dogukan-bicer/Marel-Arge/README.md

# Marel-Arge
marel arge çalışma dosyaları
