dogukan-bicer/Marel-Arge/Pcb Dosyaları/Robotik Sistem/versiyon1.2 dogukan/v1.1.png

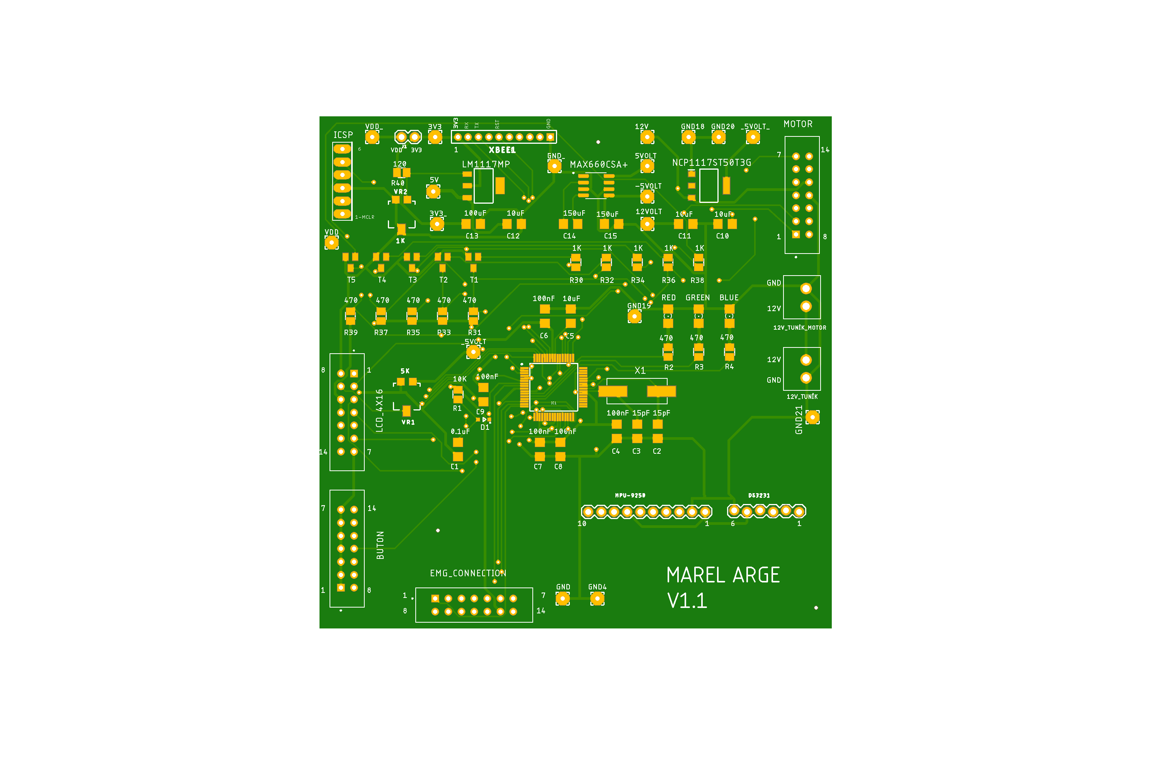
Pcb Dosyaları/Robotik Sistem/versiyon1.2 dogukan/v1.1.png
