dogukan-bicer/Marel-Arge/Pcb Dosyaları/Eldiven/eldiven/Mareltek Glove Project_esp32.brd

## EAGLE design Pcb Dosyaları/Eldiven/eldiven/Mareltek Glove Project_esp32.brd (2024-05-18)

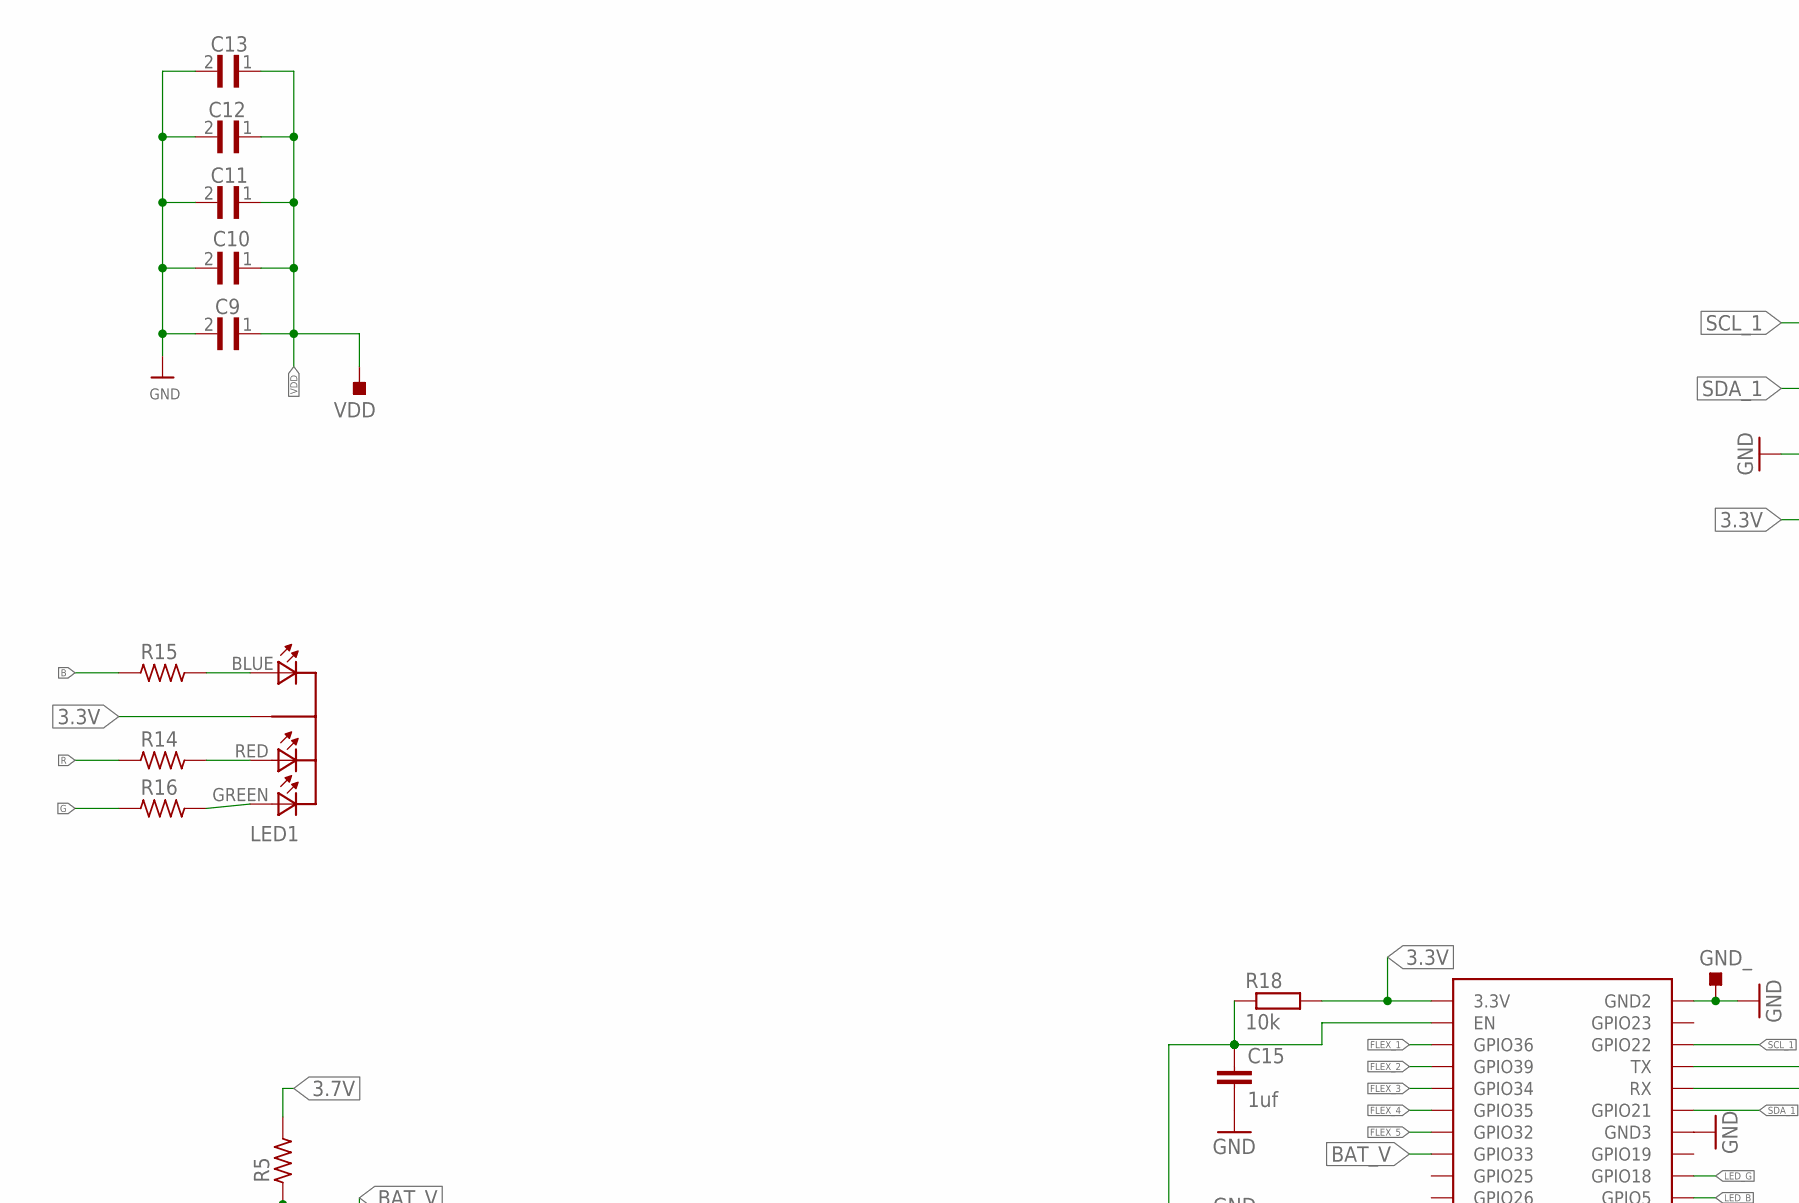
[picture p2: schematic Mareltek Glove Project_esp32.sch, part in row 1, column 1]

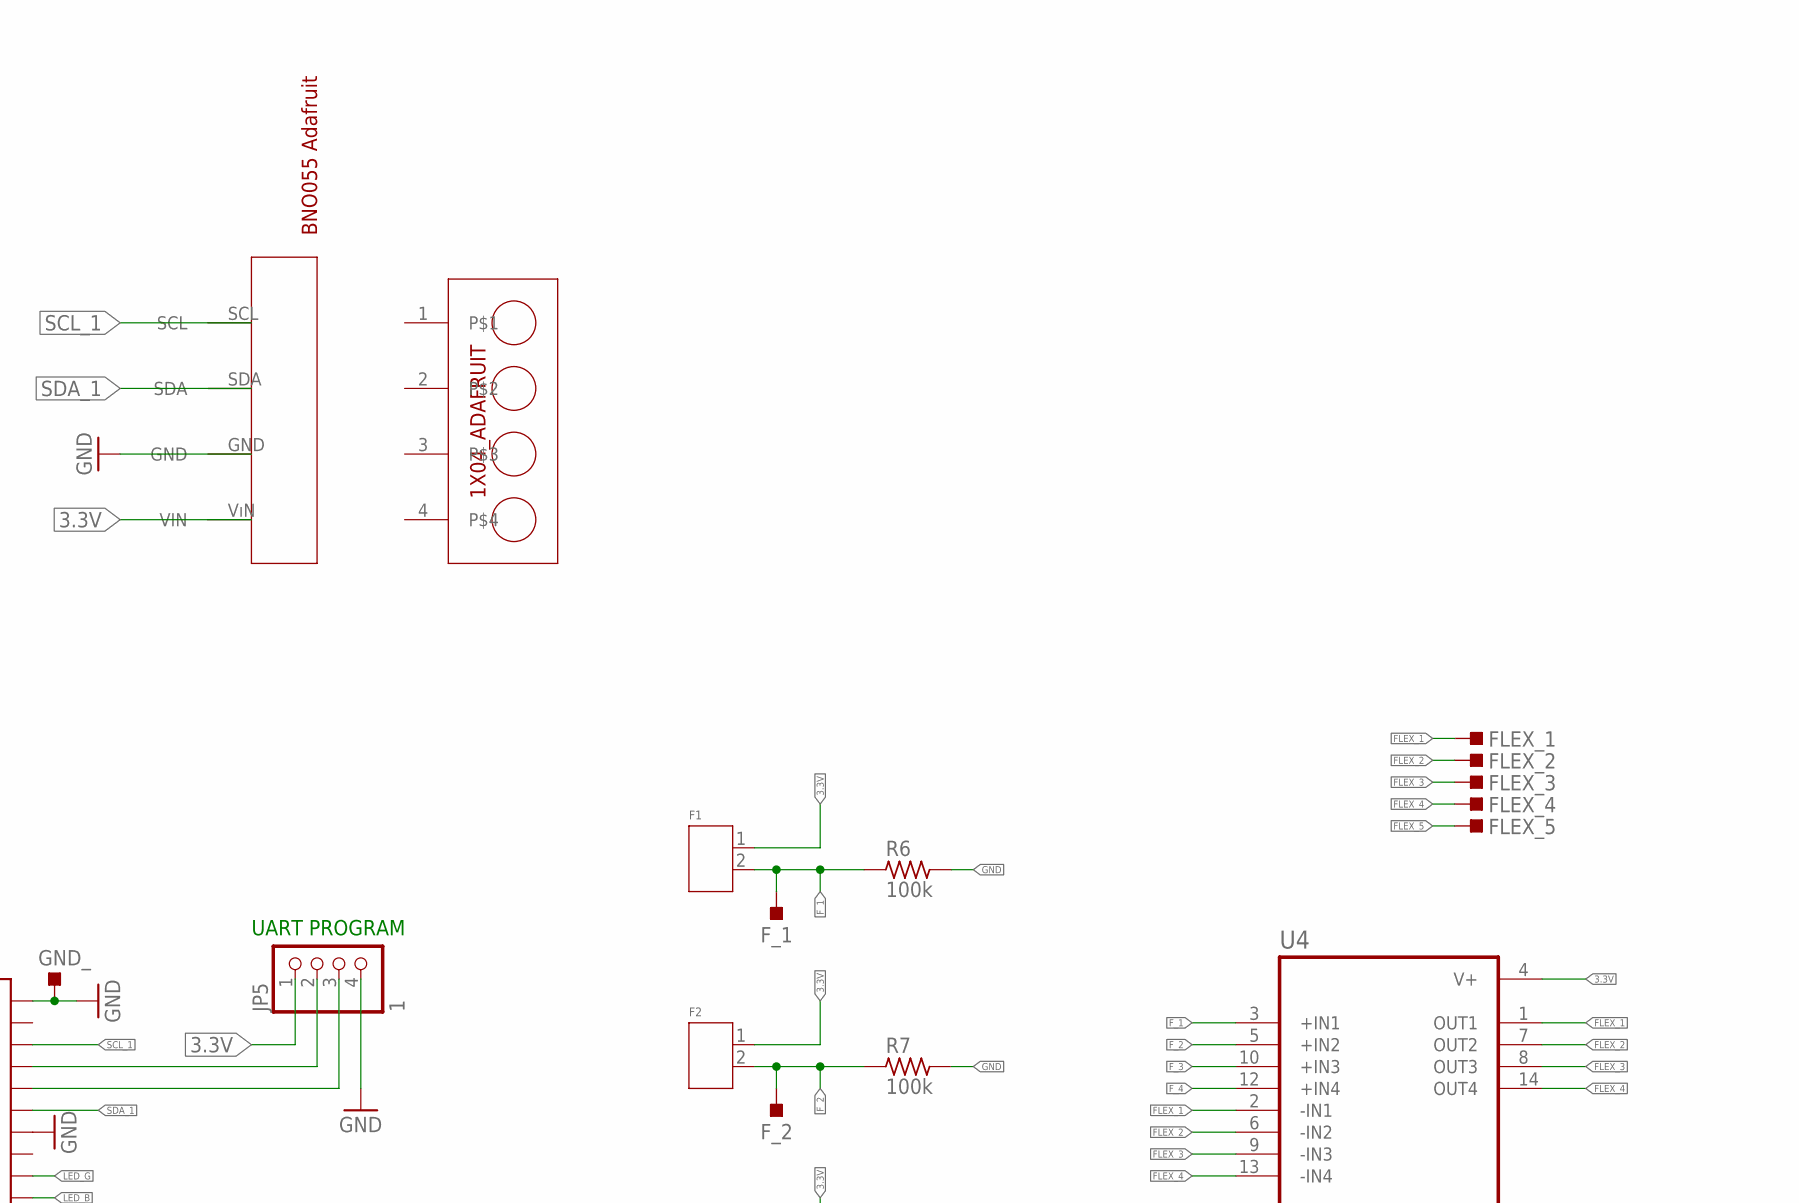
[picture p3: schematic Mareltek Glove Project_esp32.sch, part in row 1, column 2]

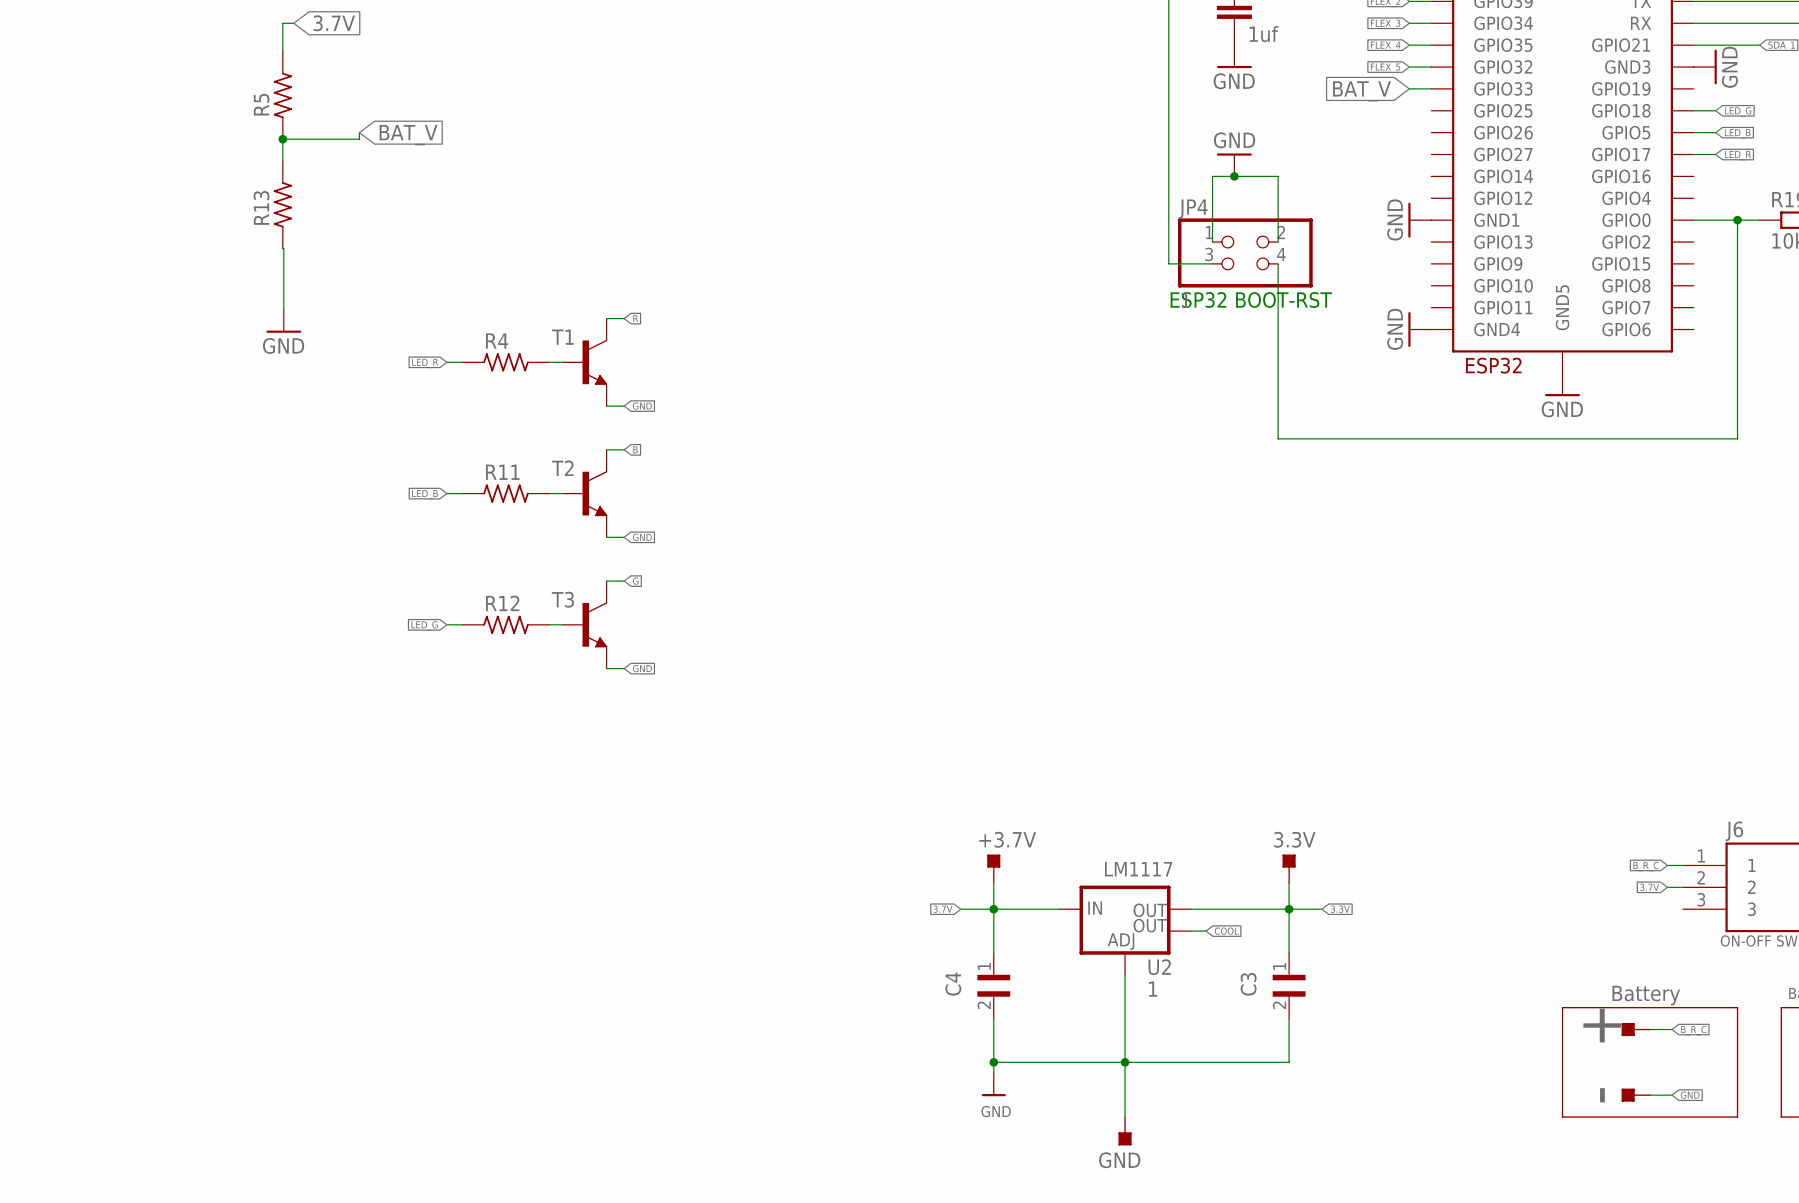
[picture p4: schematic Mareltek Glove Project_esp32.sch, part in row 2, column 1]

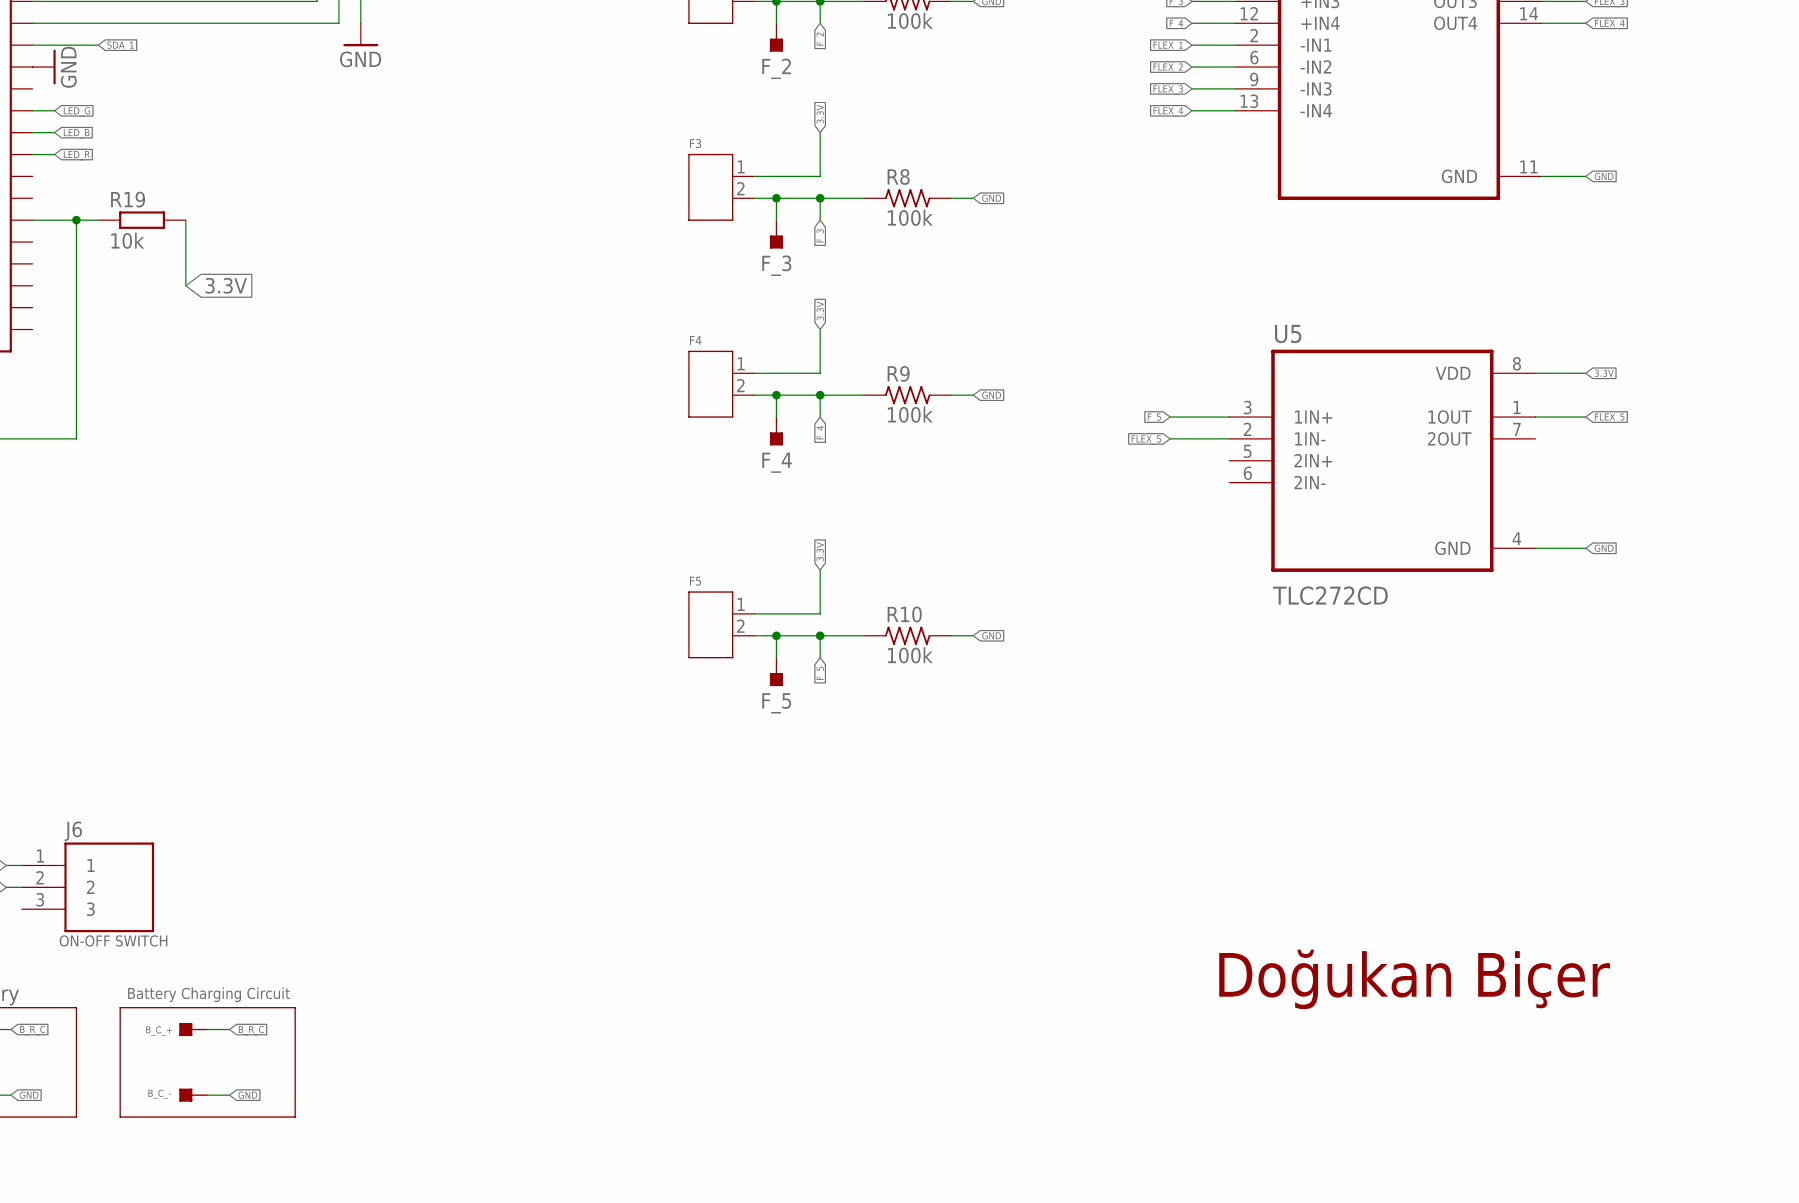
[picture p5: schematic Mareltek Glove Project_esp32.sch, part in row 2, column 2]

Parts:
3.3V: TESTPOINT_TPS-SMD-10SN; TESTPOINT_SMD-10SN
+: TESTPOINT_TPS-PAD-036; TESTPOINT_PAD-036
+3.7V: TESTPOINT_TPS-SMD-10SN; TESTPOINT_SMD-10SN
-: TESTPOINT_TPS-PAD-036; TESTPOINT_PAD-036
B_C_+: TESTPOINT_TPS-PAD-036; TESTPOINT_PAD-036
B_C_-: TESTPOINT_TPS-PAD-036; TESTPOINT_PAD-036
C3, C4: 10uF; CAPC1608X90
C9, C10, C11, C12, C13: 100nF; CAPC1608X90
C15: 1uf; C0805
F1, F2, F3, F4, F5: FLEX_CONNECTOR
FLEX_1, FLEX_2, FLEX_3, FLEX_4, FLEX_5: TESTPOINT_TPS-SMD-10SN; TESTPOINT_SMD-10SN
F_1, F_2, F_3, F_4, F_5: TESTPOINT_TPS-SMD-10SN; TESTPOINT_SMD-10SN
GND: TESTPOINT_TPS-SMD-10SN; TESTPOINT_SMD-10SN
GND_: TESTPOINT_TPS-SMD-10SN; TESTPOINT_SMD-10SN
J6: ON-OFF SWITCH; TE_5-146293-3
JP4: 1; 2X02
JP5: 1; 1X04
LED1: LED-DIP-3; DIP-4
R4, R11, R12, R14, R15, R16: 100R; RC-MASTER-SMD_R0603MP
R5, R6, R7, R8, R9, R10: 100k; RC-MASTER-SMD_R0603MP
R13: 330R; RC-MASTER-SMD_R0603MP
R18, R19: 10k; R0603
T1, T2, T3: TRANSISTORBC846BLT1SOT23-BEC; SOT23-BEC
U2: 1; SOT223
U4: LM324; SOIC127P600X175-14N
U5: TLC272CD; SOIC127P599X175-8N
U$2: BNO055_ADAFRUIT; 1X06_ROUND_76
U$4: 1X04_ADAFRUIT; 1X04_ROUND_76
U$7: ESP32-WROOM
VDD: TESTPOINT_TPS-SMD-10SN; TESTPOINT_SMD-10SN

Connections:
3.3V: 3.3V.TP, C3.1, F1.1, F2.1, F3.1, F4.1, F5.1, JP5.1, LED1.COMMON_CATHODE (COM-CATHODE), R18.2, R19.2, U2.2 (OUT), U4.4 (V+), U5.8 (VDD), U$2.VıN (VIN), U$7.3V3 (3.3V)
3.7V: +3.7V.TP, C4.1, J6.2, R5.2, U2.3 (IN)
B: R15.1, T2.C
BAT_V: R5.1, R13.2, U$7.IO33 (GPIO33)
B_R_C: +.1, B_C_+.1, J6.1
COOL: U2.4 (OUT)
ESP32_RESET: C15.1, JP4.3, R18.1, U$7.EN
FLEX_1: FLEX_1.TP, U4.1 (OUT1), U4.2 (-IN1), U$7.SENSOR_VP (GPIO36)
FLEX_2: FLEX_2.TP, U4.6 (-IN2), U4.7 (OUT2), U$7.SENSOR_VN (GPIO39)
FLEX_3: FLEX_3.TP, U4.8 (OUT3), U4.9 (-IN3), U$7.IO34 (GPIO34)
FLEX_4: FLEX_4.TP, U4.13 (-IN4), U4.14 (OUT4), U$7.IO35 (GPIO35)
FLEX_5: FLEX_5.TP, U5.1 (1OUT), U5.2 (1IN-), U$7.IO32 (GPIO32)
F_1: F1.2, F_1.TP, R6.1, U4.3 (+IN1)
F_2: F2.2, F_2.TP, R7.1, U4.5 (+IN2)
F_3: F3.2, F_3.TP, R8.1, U4.10 (+IN3)
F_4: F4.2, F_4.TP, R9.1, U4.12 (+IN4)
F_5: F5.2, F_5.TP, R10.1, U5.3 (1IN+)
G: R16.1, T3.C
GND: -.1, B_C_-.1, C3.2, C4.2, C9.2, C10.2, C11.2, C12.2, C13.2, C15.2, GND.TP, GND_.TP, JP4.1, JP4.2, JP5.4, R6.2, R7.2, R8.2, R9.2, R10.2, R13.1, T1.E, T2.E, T3.E, U2.1 (ADJ), U4.11 (GND), U5.4 (GND), U$2.GND, U$7.GND1, U$7.GND2, U$7.GND3, U$7.GND4, U$7.GND5
LED_B: R11.1, U$7.IO5 (GPIO5)
LED_G: R12.1, U$7.IO18 (GPIO18)
LED_R: R4.1, U$7.IO17 (GPIO17)
unnamed: R4.2, T1.B
unnamed: R11.2, T2.B
unnamed: LED1.RED, R14.2
unnamed: LED1.BLUE, R15.2
unnamed: LED1.GREEN, R16.2
unnamed: R12.2, T3.B
unnamed: JP5.2, U$7.TX
unnamed: JP5.3, U$7.RX
unnamed: JP4.4, R19.1, U$7.IO0 (GPIO0)
R: R14.1, T1.C
SCL_1: U$2.SCL, U$7.IO22 (GPIO22)
SDA_1: U$2.SDA, U$7.IO21 (GPIO21)
VDD: C9.1, C10.1, C11.1, C12.1, C13.1, VDD.TP

Notes on the sheet:
Doğukan Biçer
LM1117
Battery
Battery Charging Circuit
ESP32 BOOT-RST
UART PROGRAM

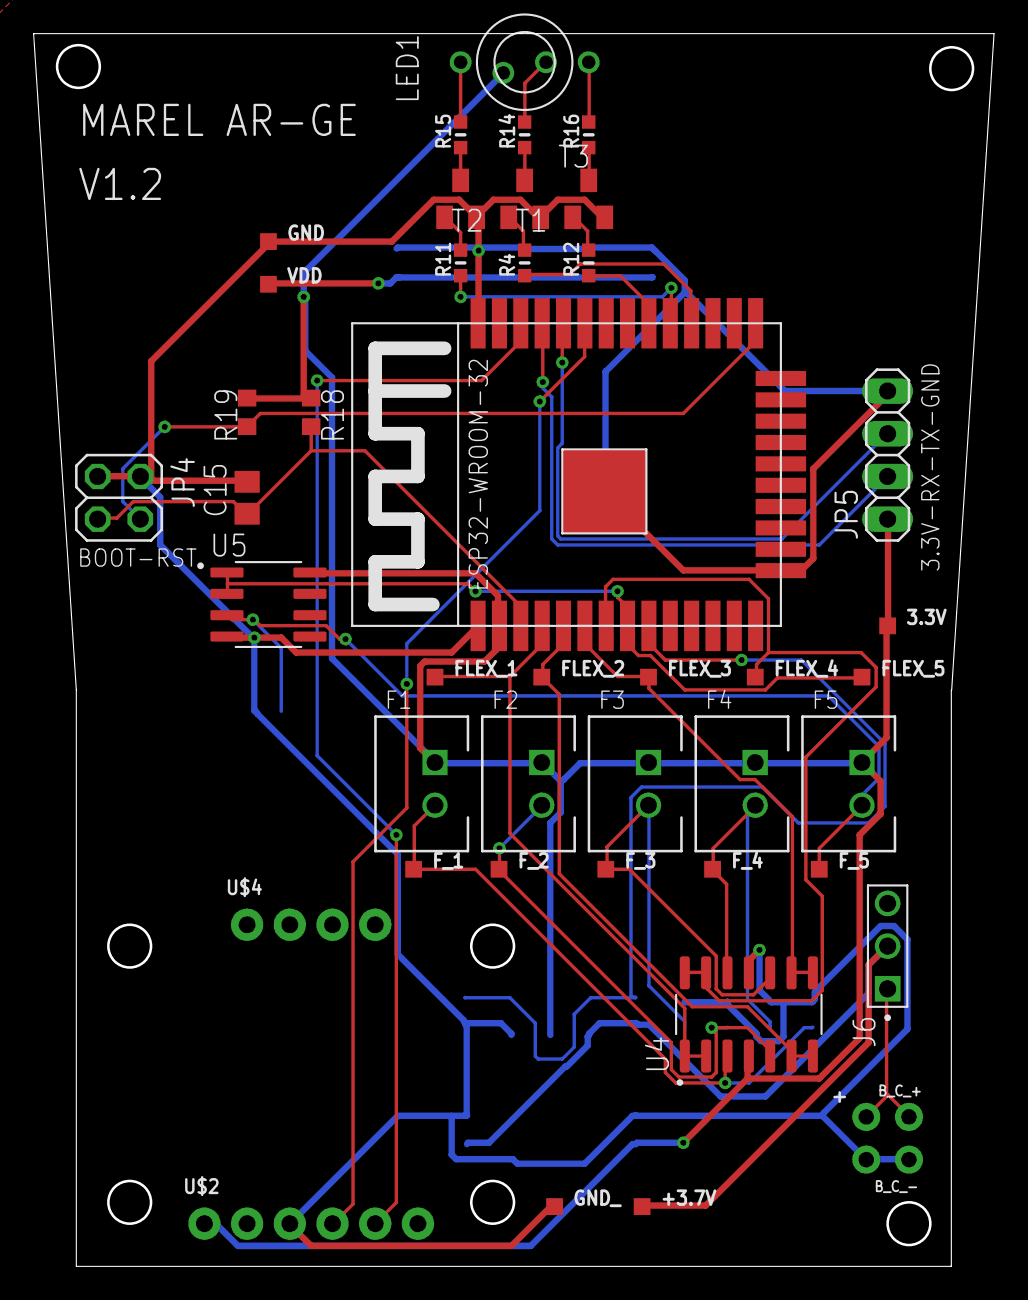
[picture p6: board Mareltek Glove Project_esp32.brd from above]

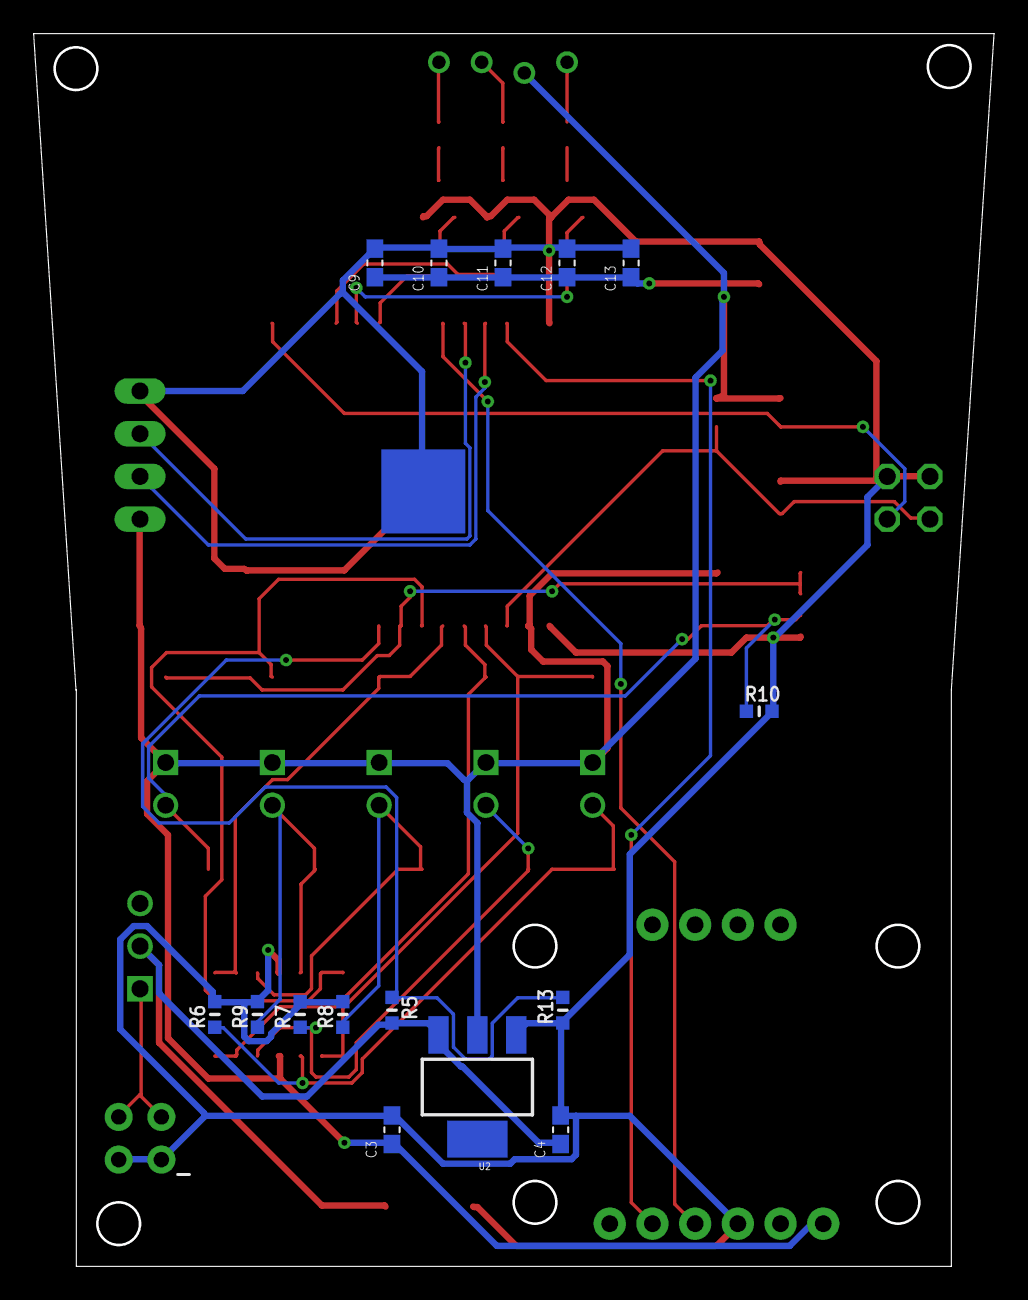
[picture p7: board Mareltek Glove Project_esp32.brd from below]

Board: 2 copper layers, 57.1 x 73.3 mm, 60 parts (16 on the bottom side), 34 nets.
