dogukan-bicer/Marel-Arge/Pcb Dosyaları/Robotik Sistem/versiyon1.2 dogukan/v1.1.brd

## EAGLE design Pcb Dosyaları/Robotik Sistem/versiyon1.2 dogukan/v1.1.brd (2024-05-18)

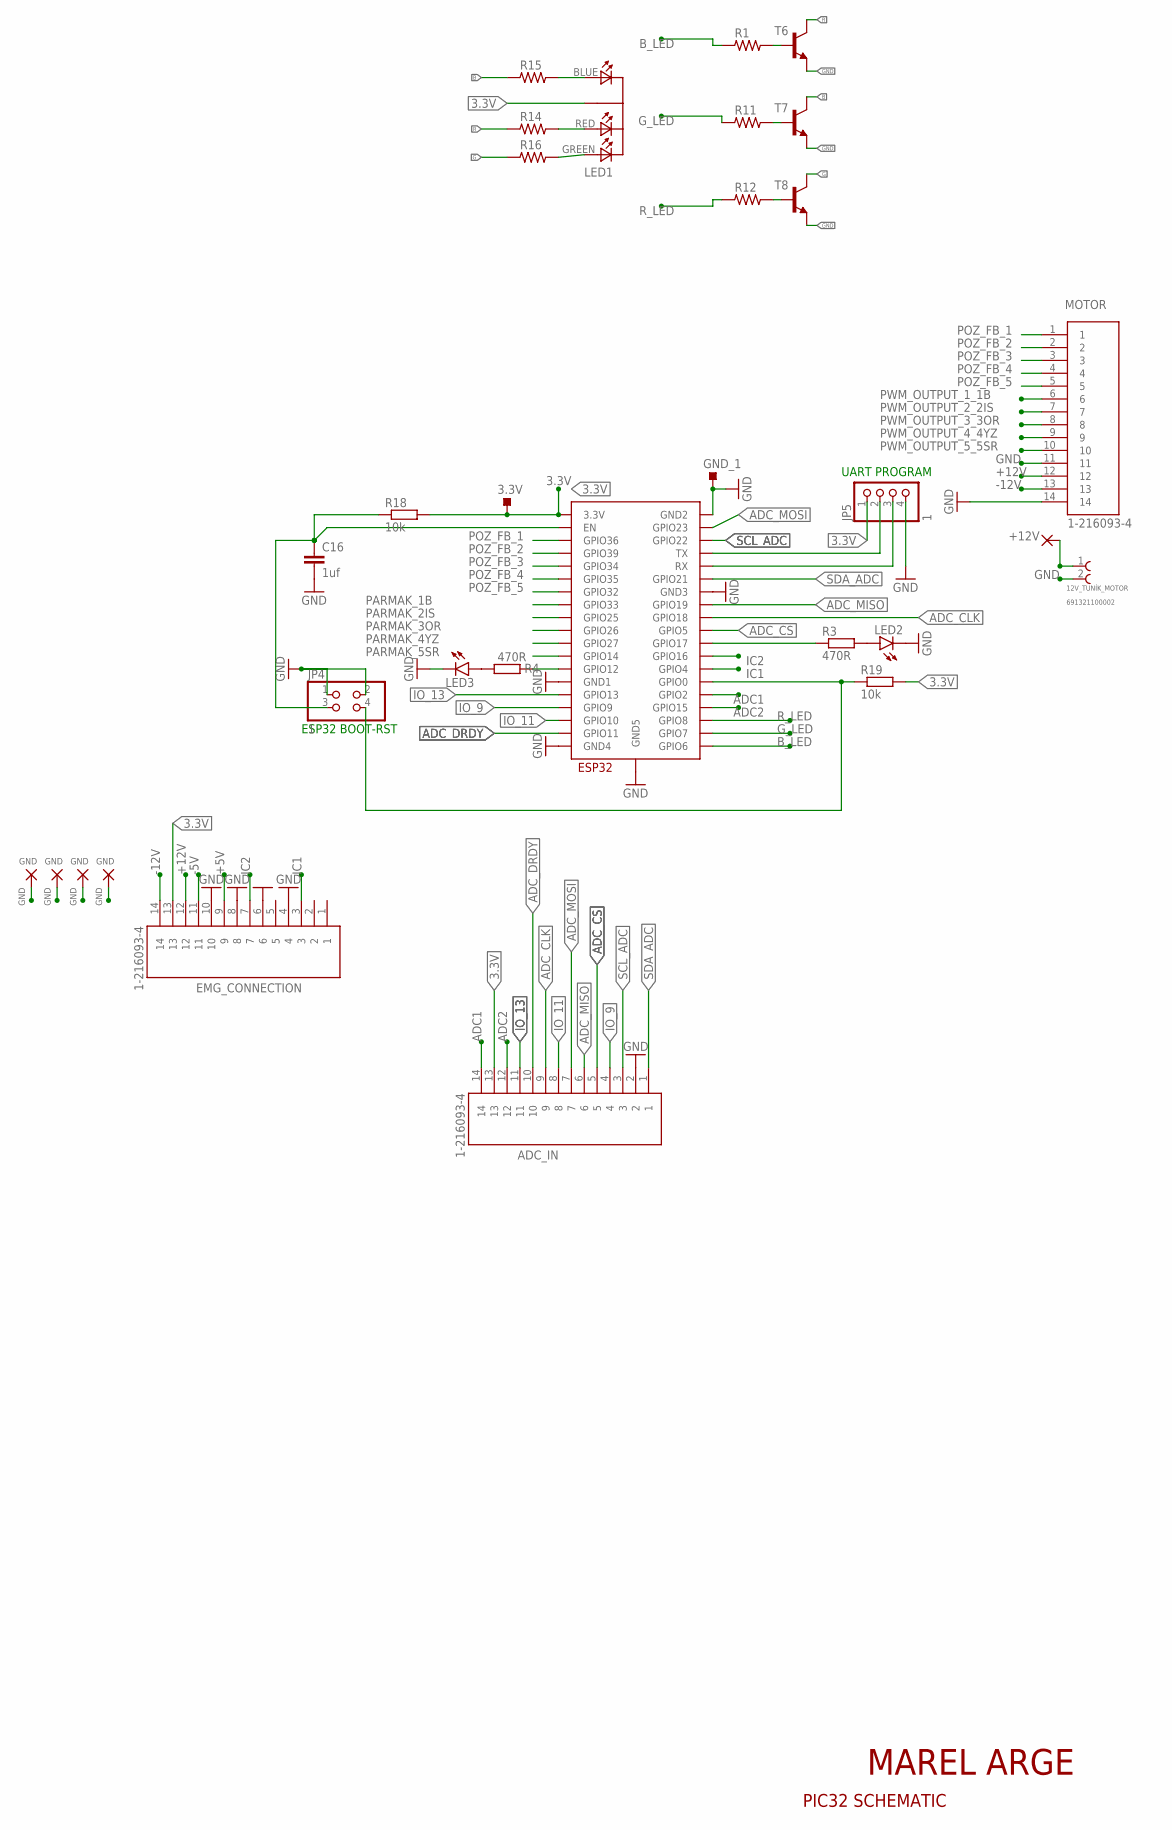
[picture p8: schematic v1.1.sch, sheet 1, PIC32 CONNECTION]

Parts:
3.3V: TESTPOINT_TPS-SMD-10SN; TESTPOINT_SMD-10SN
12VOLT: 12V; 2,54/0,8
12V_TUNİK_MOTOR: 691321100002
ADC_IN: 1-216093-4; TE_1-216093-4
C16: 1uf; C0805
EMG_CONNECTION: 1-216093-4; TE_1-216093-4
GND18, GND19, GND20, GND21: GND; 2,54/0,8
GND_1: TESTPOINT_TPS-SMD-10SN; TESTPOINT_SMD-10SN
JP4: 1; 2X02
JP5: 1; 1X04
LED1: LED-DIP-3; DIP-4
LED2, LED3: LED5MM
MOTOR: 1-216093-4; TE_1-216093-4
R1, R11, R12, R14, R15, R16: 100R; RC-MASTER-SMD_R0603MP
R3, R4: 470R; R0603
R18, R19: 10k; R0603
T6, T7, T8: TRANSISTORBC846BLT1SOT23-BEC; SOT23-BEC
U$7: ESP32-WROOM

Connections:
3.3V: 3.3V.TP, ADC_IN.13, EMG_CONNECTION.13, JP5.1, LED1.COMMON_CATHODE (COM-CATHODE), R18.2, R19.2, U$7.3V3 (3.3V); also elsewhere on the board
+5V: EMG_CONNECTION.9; also elsewhere on the board
+12V: 12VOLT.1, 12V_TUNİK_MOTOR.1, EMG_CONNECTION.12, MOTOR.12; also elsewhere on the board
-5V: EMG_CONNECTION.11; also elsewhere on the board
-12V: EMG_CONNECTION.14, MOTOR.13; also elsewhere on the board
ADC1: ADC_IN.14, U$7.IO2 (GPIO2)
ADC2: ADC_IN.12, U$7.IO15 (GPIO15)
ADC_CLK: ADC_IN.9, U$7.IO18 (GPIO18)
ADC_CS: ADC_IN.5, U$7.IO5 (GPIO5)
ADC_DRDY: ADC_IN.10, U$7.CMD (GPIO11)
ADC_MISO: ADC_IN.6, U$7.IO19 (GPIO19)
ADC_MOSI: ADC_IN.7, U$7.IO23 (GPIO23)
B: R14.1, T7.C
B_LED: R1.1, U$7.CLK (GPIO6)
ESP32_RESET: C16.1, JP4.3, R18.1, U$7.EN
G: R16.1, T8.C
GND: 12V_TUNİK_MOTOR.2, ADC_IN.2, C16.2, EMG_CONNECTION.4, EMG_CONNECTION.6, EMG_CONNECTION.8, EMG_CONNECTION.10, GND18.1, GND19.1, GND20.1, GND21.1, GND_1.TP, JP4.1, JP4.2, JP5.4, LED2.K (C), LED3.K (C), MOTOR.11, MOTOR.14, T6.E, T7.E, T8.E, U$7.GND1, U$7.GND2, U$7.GND3, U$7.GND4, U$7.GND5; also elsewhere on the board
G_LED: R11.1, U$7.SD0 (GPIO7)
IC1: EMG_CONNECTION.3, U$7.IO4 (GPIO4)
IC2: EMG_CONNECTION.7, U$7.IO16 (GPIO16)
IO_9: ADC_IN.4, U$7.SD2 (GPIO9)
IO_11: ADC_IN.8, U$7.SD3 (GPIO10)
IO_13: ADC_IN.11, U$7.IO13 (GPIO13)
unnamed: R11.2, T7.B
unnamed: R1.2, T6.B
unnamed: LED1.RED, R14.2
unnamed: R12.2, T8.B
unnamed: LED1.BLUE, R15.2
unnamed: LED1.GREEN, R16.2
unnamed: JP5.2, U$7.TX
unnamed: JP5.3, U$7.RX
unnamed: JP4.4, R19.1, U$7.IO0 (GPIO0)
unnamed: LED2.A, R3.2
unnamed: R3.1, U$7.IO17 (GPIO17)
unnamed: LED3.A, R4.2
unnamed: R4.1, U$7.IO12 (GPIO12)
PARMAK_1B: U$7.IO33 (GPIO33); also elsewhere on the board
PARMAK_2IS: U$7.IO25 (GPIO25); also elsewhere on the board
PARMAK_3OR: U$7.IO26 (GPIO26); also elsewhere on the board
PARMAK_4YZ: U$7.IO27 (GPIO27); also elsewhere on the board
PARMAK_5SR: U$7.IO14 (GPIO14); also elsewhere on the board
POZ_FB_1: MOTOR.1, U$7.SENSOR_VP (GPIO36)
POZ_FB_2: MOTOR.2, U$7.SENSOR_VN (GPIO39)
POZ_FB_3: MOTOR.3, U$7.IO34 (GPIO34)
POZ_FB_4: MOTOR.4, U$7.IO35 (GPIO35)
POZ_FB_5: MOTOR.5, U$7.IO32 (GPIO32)
PWM_OUTPUT_1_1B: MOTOR.6; also elsewhere on the board
PWM_OUTPUT_2_2IS: MOTOR.7; also elsewhere on the board
PWM_OUTPUT_3_3OR: MOTOR.8; also elsewhere on the board
PWM_OUTPUT_4_4YZ: MOTOR.9; also elsewhere on the board
PWM_OUTPUT_5_5SR: MOTOR.10; also elsewhere on the board
R: R15.1, T6.C
R_LED: R12.1, U$7.SD1 (GPIO8)
SCL_ADC: ADC_IN.3, U$7.IO22 (GPIO22)
SDA_ADC: ADC_IN.1, U$7.IO21 (GPIO21)

Notes on the sheet:
MAREL ARGE
PIC32 SCHEMATIC
ESP32 BOOT-RST
UART PROGRAM
-12V
+12V

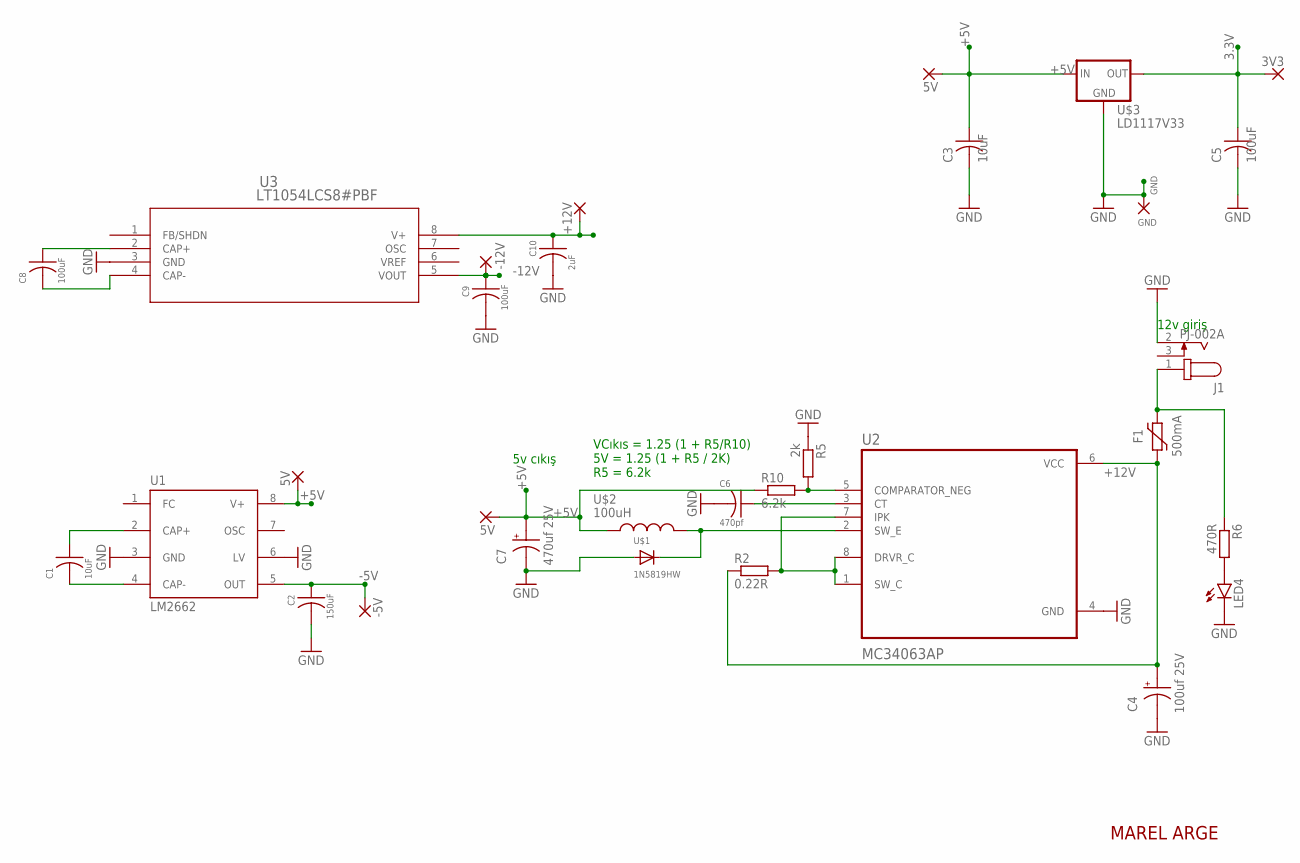
[picture p9: schematic v1.1.sch, sheet 2, REGULATOR]

Parts:
3V3_1: 3V3; 2,54/0,8
5V, 5V1: 5V; 2,54/0,8
+5V: 5V; 2,54/0,8
+12V: +12V; 2,54/0,8
-5V: -5V; 2,54/0,8
-12V: -12V; 2,54/0,8
C1, C3: 10uF; C1206
C2: 150uF; C1206
C4: 100uf 25V; X
C5, C8, C9: 100uF; C1206
C6: 470pf; C1206
C7: 470uf 25V; X
C10: 2uF; C1206
F1: 500mA; 1206L
GND13: GND; 2,54/0,8
J1: PJ-002A; CUI_PJ-002A
LED4: LED5MM
R2: 0.22R; R2512
R5: 2k; R0805
R6: 470R; R0603
R10: 6.2k; R0805
U1: LM2662; SO08
U2: MC34063AP; DIP794W45P254L959H508Q8
U3: LT1054LCS8#PBF; SO-8_S
U$1: 1N5819HW; SOD-123-EDITED
U$2: 100uH; L7070
U$3: LD1117V33

Connections:
3.3V: 3V3_1.1, C5.1, U$3.OUT; also elsewhere on the board
12_IN: F1.P$2 (2), J1.1, R6.1
+5V: 5V.1, 5V1.1, +5V.1, C3.1, C7.A, R10.1, U1.8 (V+), U$2.1, U$3.IN; also elsewhere on the board
+12V: +12V.1, C4.A, C10.1, F1.P$1 (1), R2.1, U2.6 (VCC), U3.8 (V+); also elsewhere on the board
-5V: -5V.1, C2.1, U1.5 (OUT); also elsewhere on the board
-12V: -12V.1, C9.1, U3.5 (VOUT); also elsewhere on the board
GND: C2.2, C3.2, C4.C, C5.2, C6.2, C7.C, C9.2, C10.2, GND13.1, J1.2, LED4.K (C), R5.1, U1.3 (GND), U1.6 (LV), U2.4 (GND), U3.3 (GND), U$1.A, U$3.GND; also elsewhere on the board
unnamed: C1.1, U1.2 (CAP+)
unnamed: C1.2, U1.4 (CAP-)
unnamed: R2.2, U2.1 (SW_C), U2.7 (IPK), U2.8 (DRVR_C)
unnamed: C8.1, U3.2 (CAP+)
unnamed: U2.2 (SW_E), U$1.C, U$2.2
unnamed: R5.2, R10.2, U2.5 (COMPARATOR_NEG)
unnamed: C6.1, U2.3 (CT)
unnamed: C8.2, U3.4 (CAP-)
unnamed: LED4.A, R6.2
VREF: U3.6 (VREF)

Notes on the sheet:
MAREL ARGE
5v cıkış
12v giriş
VCıkıs = 1.25 (1 + R5/R10) 5V = 1.25 (1 + R5 / 2K) R5 = 6.2k

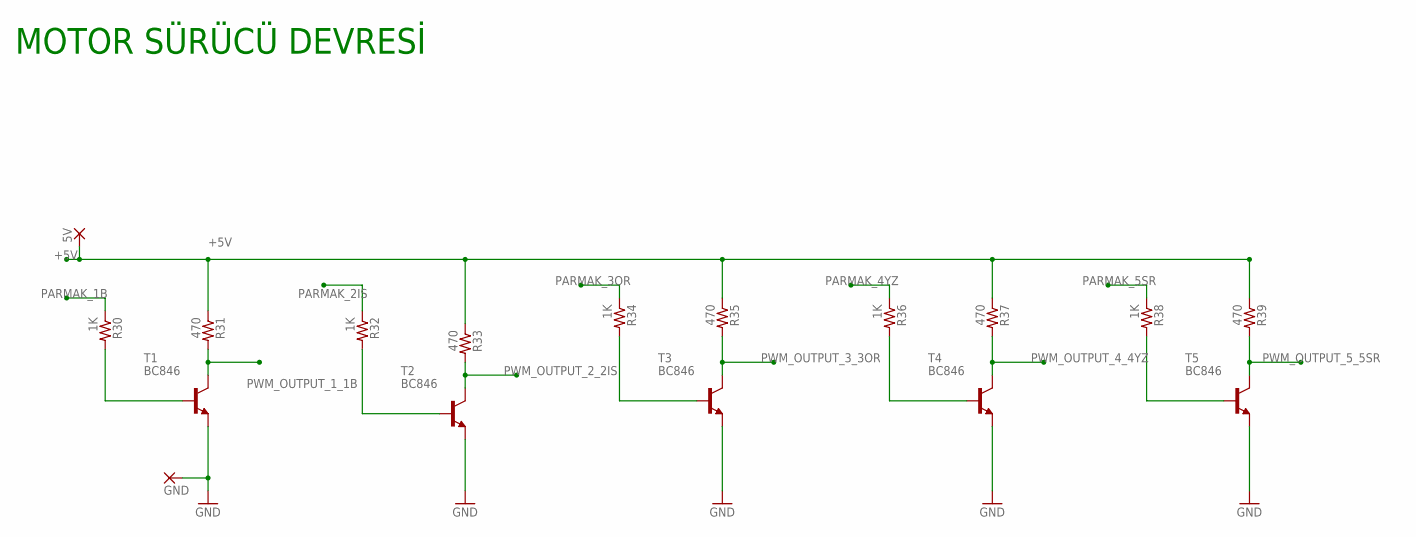
[picture p10: schematic v1.1.sch, sheet 3, MOTOR DRIVER]

Parts:
GND_: GND; 2,54/0,8
R30, R32, R34, R36, R38: 1K; M0805
R31, R33, R35, R37, R39: 470; M0805
T1, T2, T3, T4, T5: BC846; SOT23
_5VOLT: 5V; 2,54/0,8

Connections:
+5V: R31.1, R33.1, R35.1, R37.1, R39.1, _5VOLT.1; also elsewhere on the board
GND: GND_.1, T1.2 (E), T2.2 (E), T3.2 (E), T4.2 (E), T5.2 (E); also elsewhere on the board
unnamed: R30.2, T1.1 (B)
unnamed: R32.2, T2.1 (B)
unnamed: R34.2, T3.1 (B)
unnamed: R36.2, T4.1 (B)
unnamed: R38.2, T5.1 (B)
PARMAK_1B: R30.1; also elsewhere on the board
PARMAK_2IS: R32.1; also elsewhere on the board
PARMAK_3OR: R34.1; also elsewhere on the board
PARMAK_4YZ: R36.1; also elsewhere on the board
PARMAK_5SR: R38.1; also elsewhere on the board
PWM_OUTPUT_1_1B: R31.2, T1.3 (C); also elsewhere on the board
PWM_OUTPUT_2_2IS: R33.2, T2.3 (C); also elsewhere on the board
PWM_OUTPUT_3_3OR: R35.2, T3.3 (C); also elsewhere on the board
PWM_OUTPUT_4_4YZ: R37.2, T4.3 (C); also elsewhere on the board
PWM_OUTPUT_5_5SR: R39.2, T5.3 (C); also elsewhere on the board

Notes on the sheet:
MOTOR SÜRÜCÜ DEVRESİ

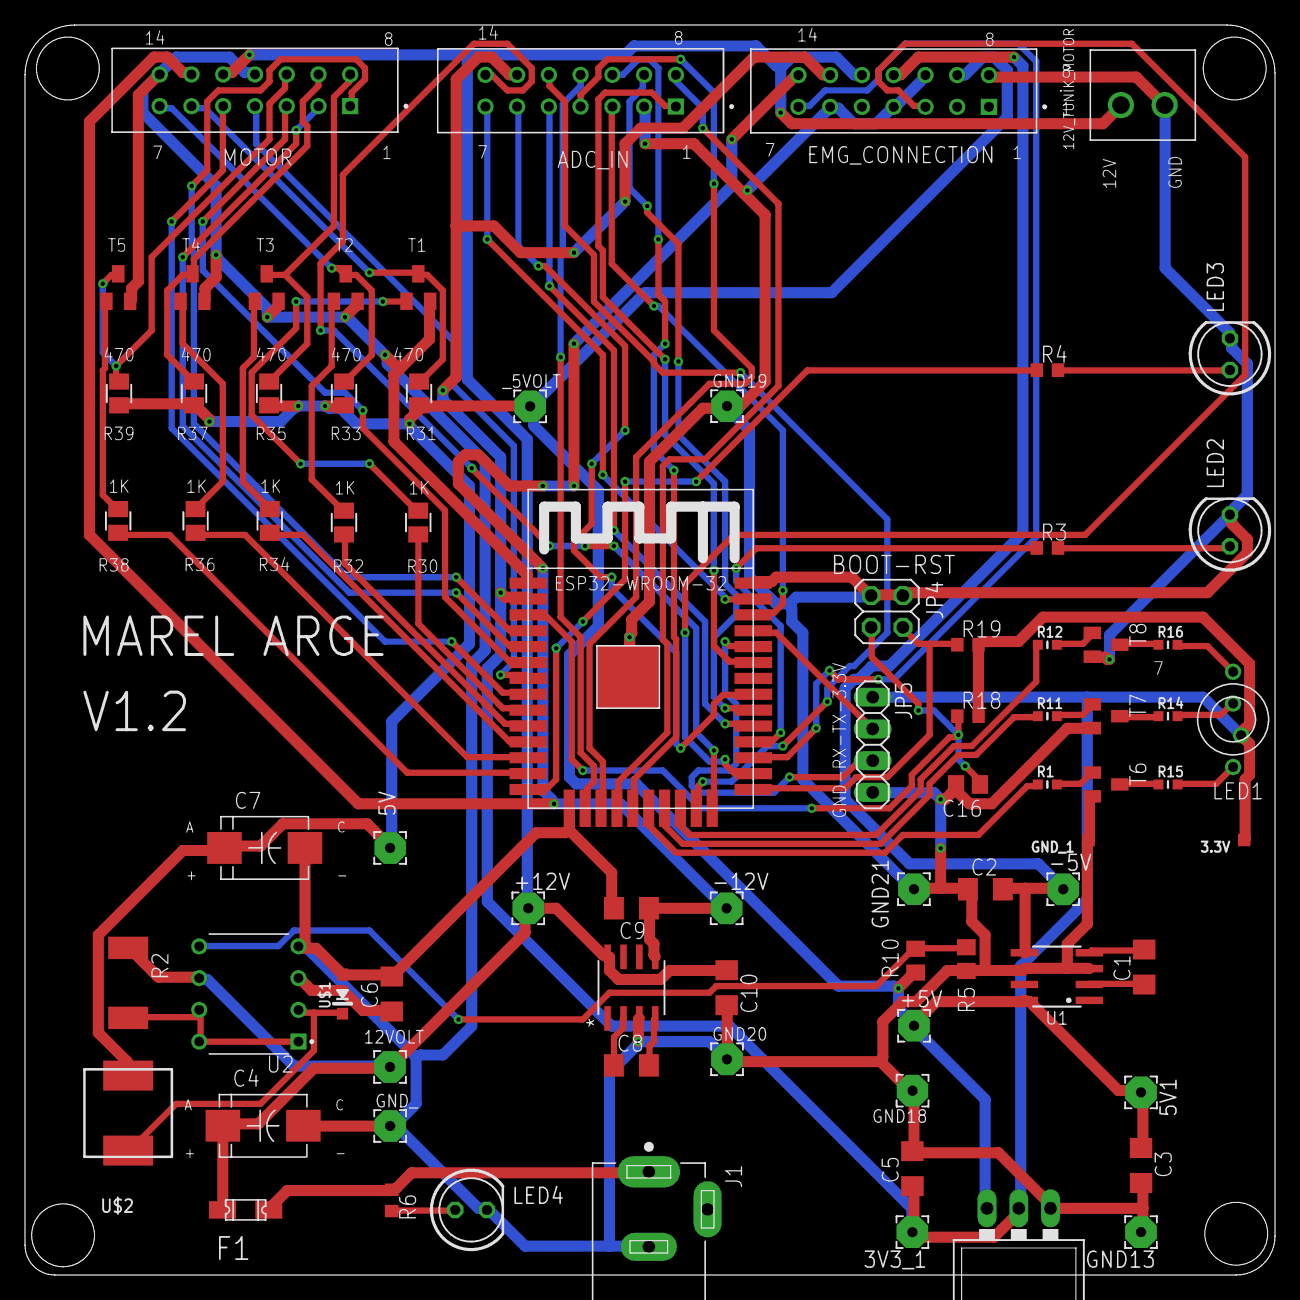
[picture p11: board v1.1.brd from above]

Board: 2 copper layers, 100.0 x 100.0 mm, 79 parts (0 on the bottom side), 70 nets.
