dogukan-bicer/Marel-Arge/(notices)

Notices in the files:
parts and their libraries:
Volks73-Kemet: Creative Commons Attribution-ShareAlike 3.0 Unported (CC BY-SA 3.0), http://creativecommons.org/licenses/by-sa/3.0/.
SparkFun-Aesthetics: Licensing: Creative Commons ShareAlike 4.0 International - https://creativecommons.org/licenses/by-sa/4.0
